srinithish/Handmovement-sensor/README.md

# Handmovement-sensor
demo

Majorly developed in Arduino (C)
