srinithish/Handmovement-sensor/band with stump.JPG

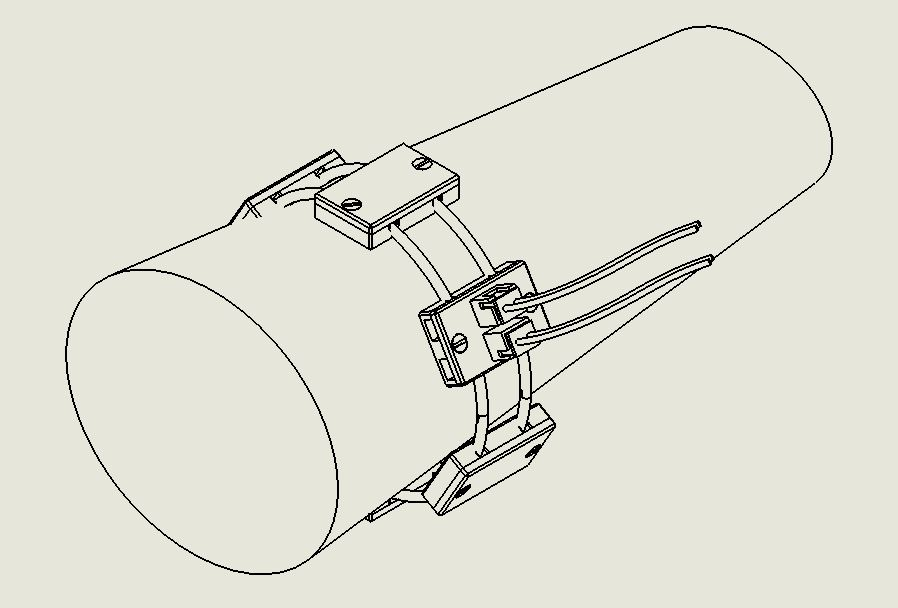
band with stump.JPG
