srinithish/Handmovement-sensor/Connector plug.JPG

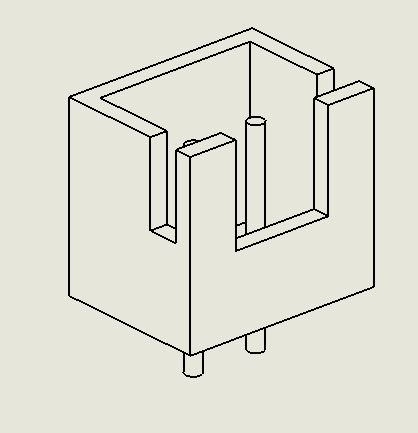
Connector plug.JPG
