srinithish/Handmovement-sensor/Detail view of u slots.JPG

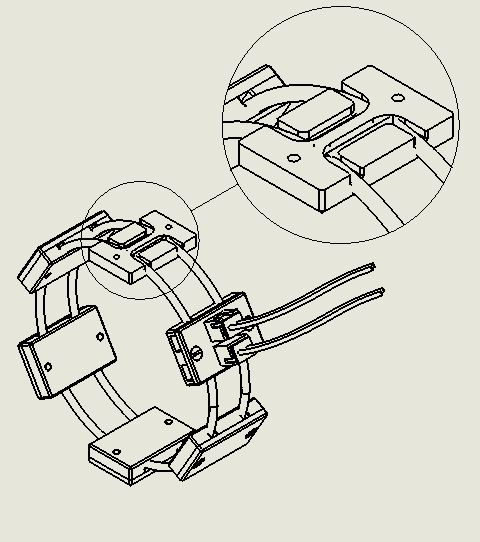
Detail view of u slots.JPG
