srinithish/Handmovement-sensor/External connections made.JPG

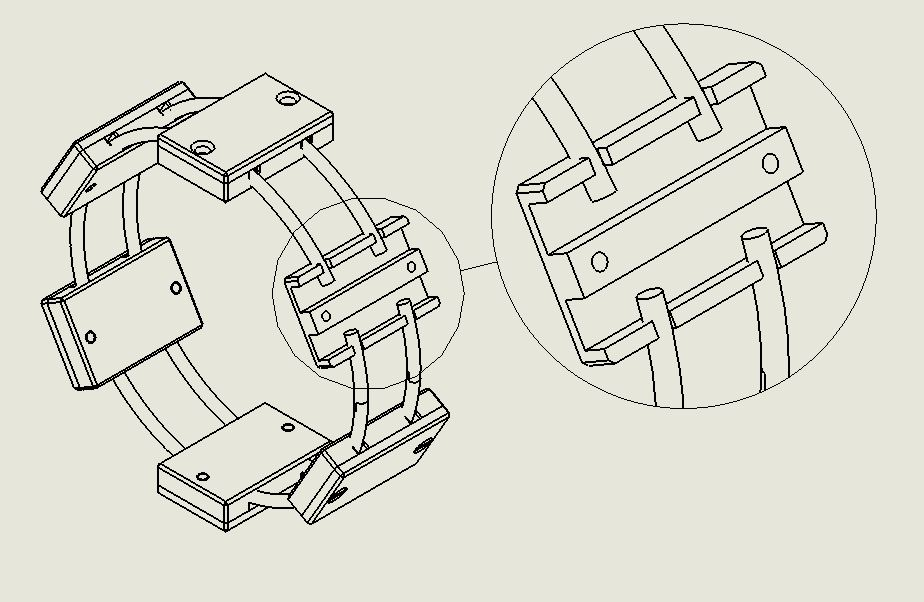
External connections made.JPG
