srinithish/Handmovement-sensor/external connections with pegs.JPG

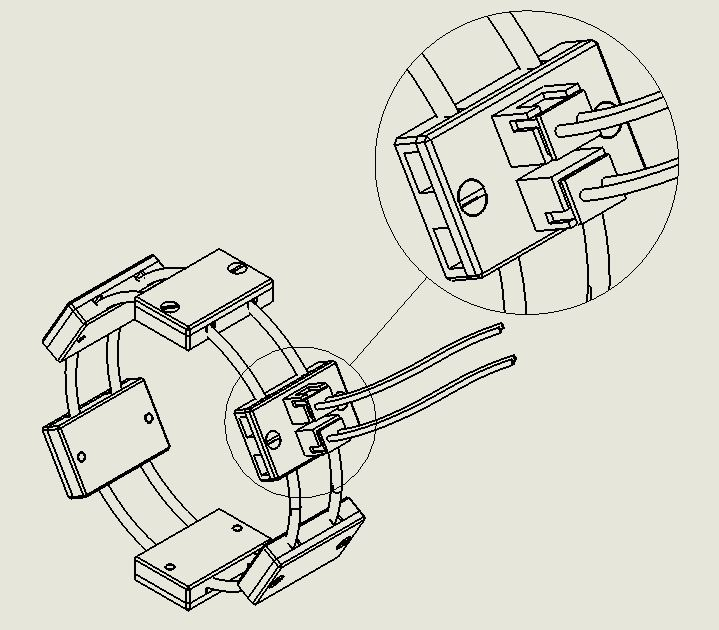
external connections with pegs.JPG
