srinithish/Handmovement-sensor/Full control with balooning.JPG

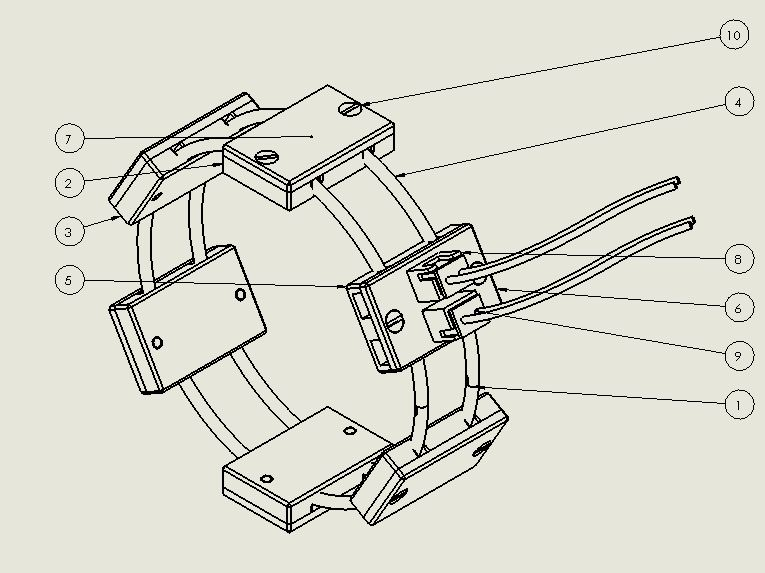
Full control with balooning.JPG
