srinithish/Handmovement-sensor/Plug male.JPG

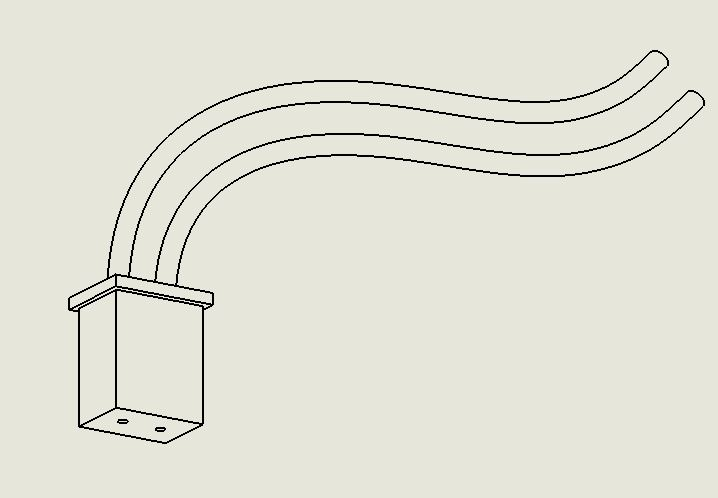
Plug male.JPG
